Stchena/ANC-Thesis/Assets/prezentacja_prototyp_ukladu_aktywnej_redukcji_poziomu_halasu.pdf

# Prototyp układu

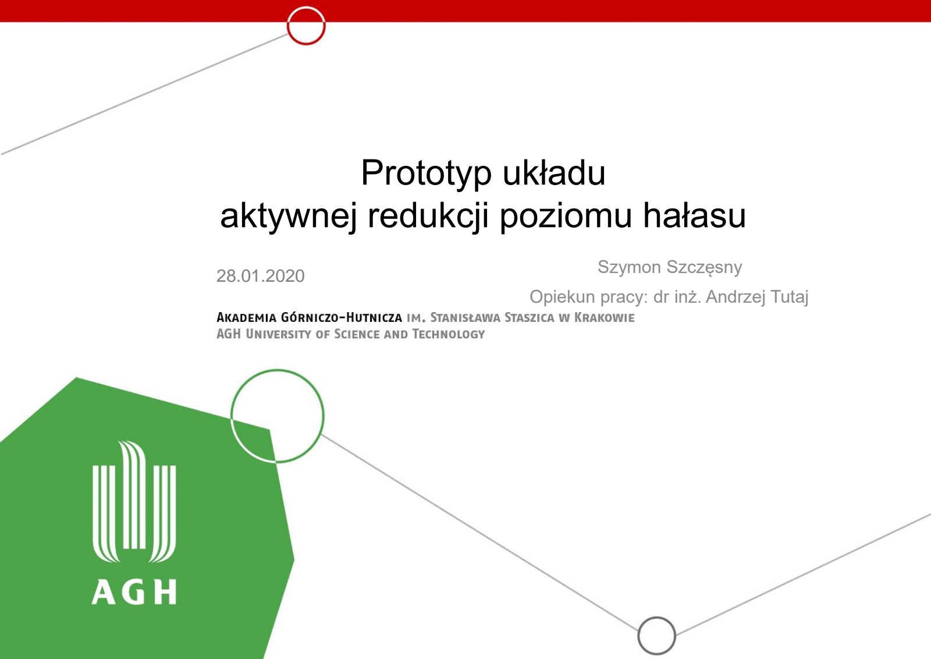
[picture p1: page 1]

# aktywnej redukcji poziomu hałasu

28.01.2020 | Szymon Szczęsny
| Opiekun pracy: dr inż. Andrzej Tutaj

# Charakterystyka Bodego nauszników – kiedy stosować tłumienie aktywne?

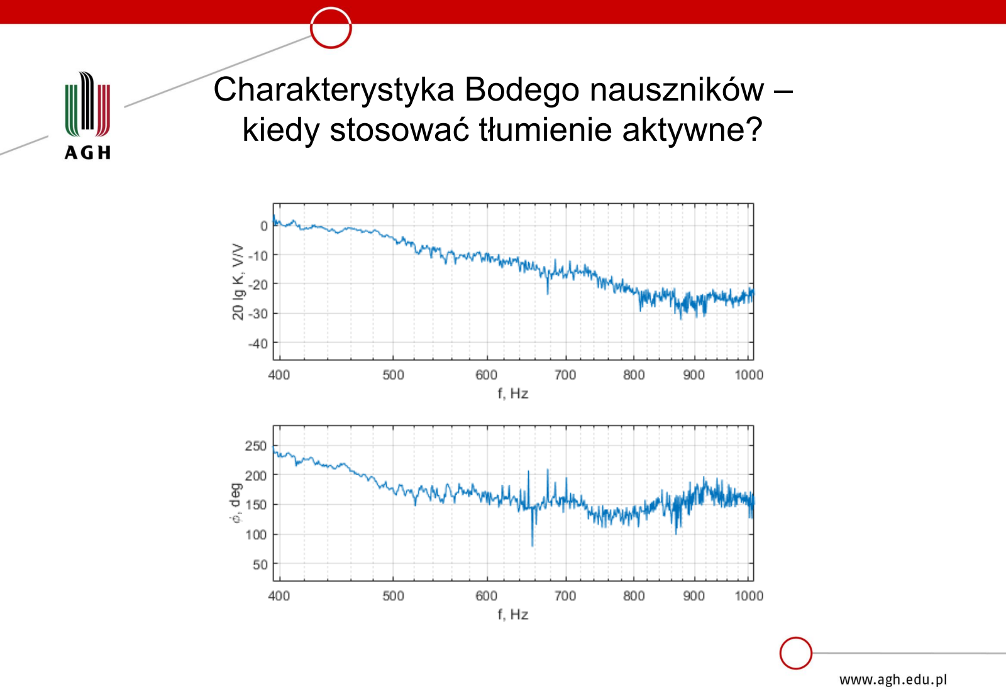
[picture p2: page 2]

Sinusoida 250 Hz

Wartość międzyszczytowa 6 Vpp

Rezonans głośnika –
wzmocnienie hałasu o 4,65 dB

Sinusoida 820 Hz

Wartość międzyszczytowa 8 Vpp

Granica pasma –
redukcja hałasu o 1 dB

# Adaptacyjny algorytm LMS

n – chwila czasu,
k – indeks współczynnika,
β – współczynnik zbieżności filtra, N – długość filtra.

FIR:

LMS:

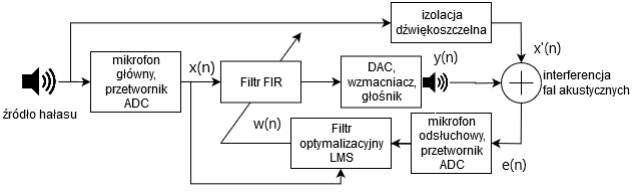
[picture p3: figure]

# Schemat działania urządzenia

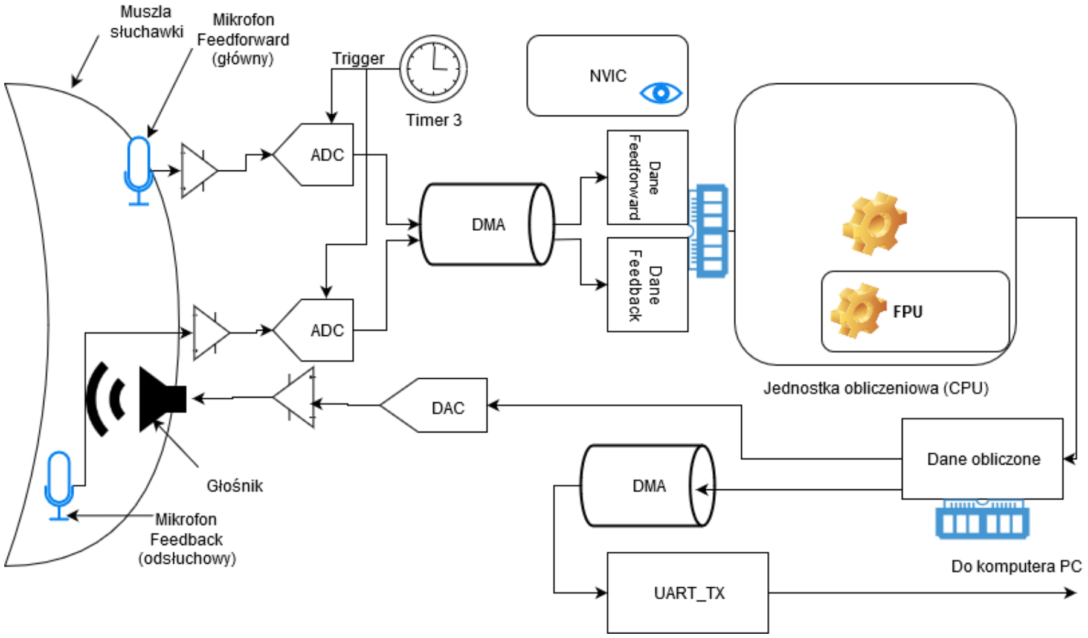
[picture p4: figure]

# Rozważane platformy sprzętowe:

# Układ analogowy

# Mikrokontroler

# Mikrokomputer

# Karta dźwiękowa

# Układ FPGA

# Główne cechy urządzenia

## » Pasywne tłumienie osiągnięte poprzez zastosowanie

nauszników tłumiących jako bazowej konstrukcji. » Układ typu feedforward-feedback,
a więc system predykcyjno-adaptacyjny.
» Użyty algorytm tłumienia to filtr FIR z LMS, rzędu 50. » Zbudowane na bazie mikrokontrolera STM32F446RE. » Transfer wag filtra LMS do PC poprzez UART.
» Tłumienie w zakresie od 400Hz do około 820Hz.

# Wyniki pomiarów

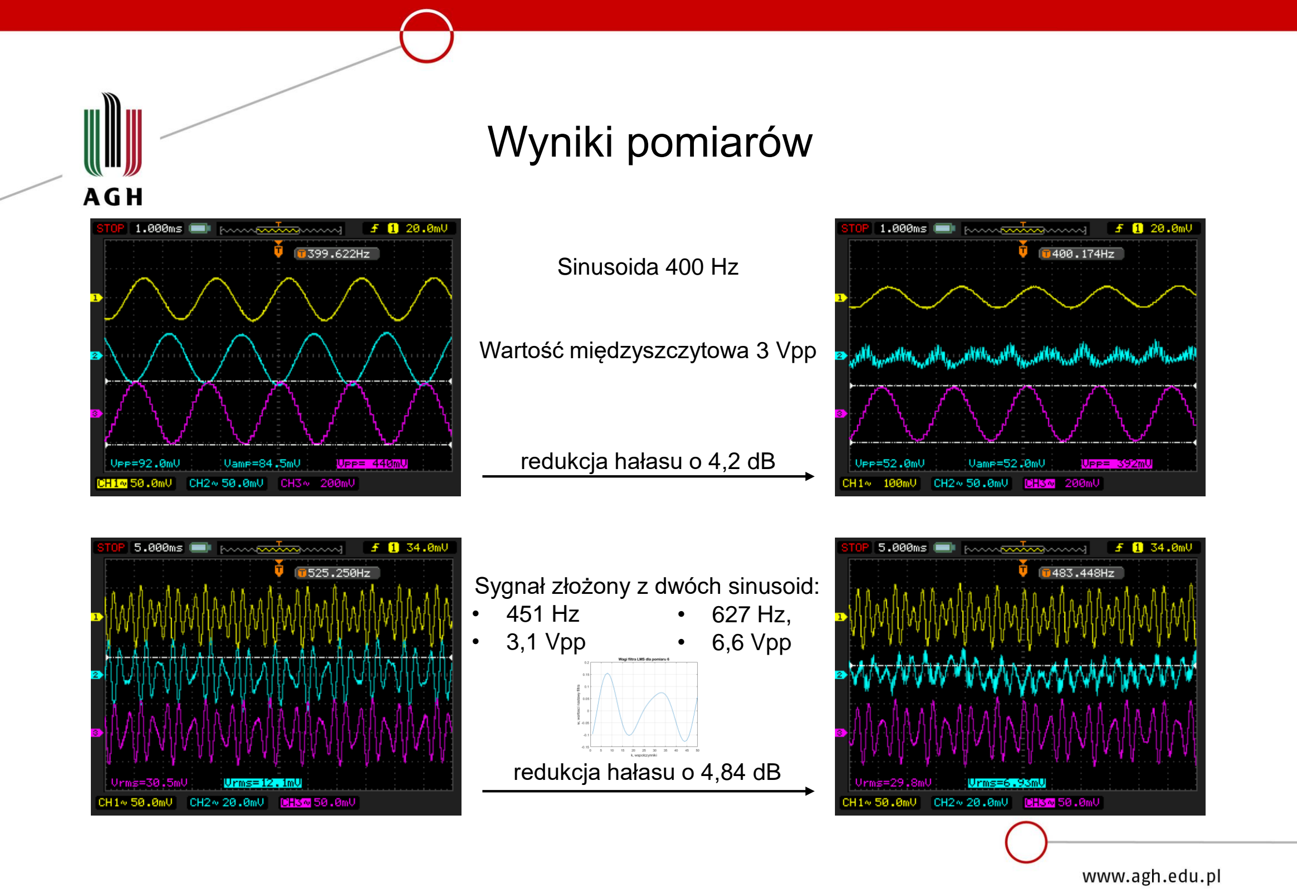
[picture p5: page 7]

Sinusoida 400 Hz

Wartość międzyszczytowa 3 Vpp

redukcja hałasu o 4,2 dB

Sygnał złożony z dwóch sinusoid:
- 451 Hz
- 3,1 Vpp
- 627 Hz,
- 6,6 Vpp

redukcja hałasu o 4,84 dB

# Wyniki pomiarów

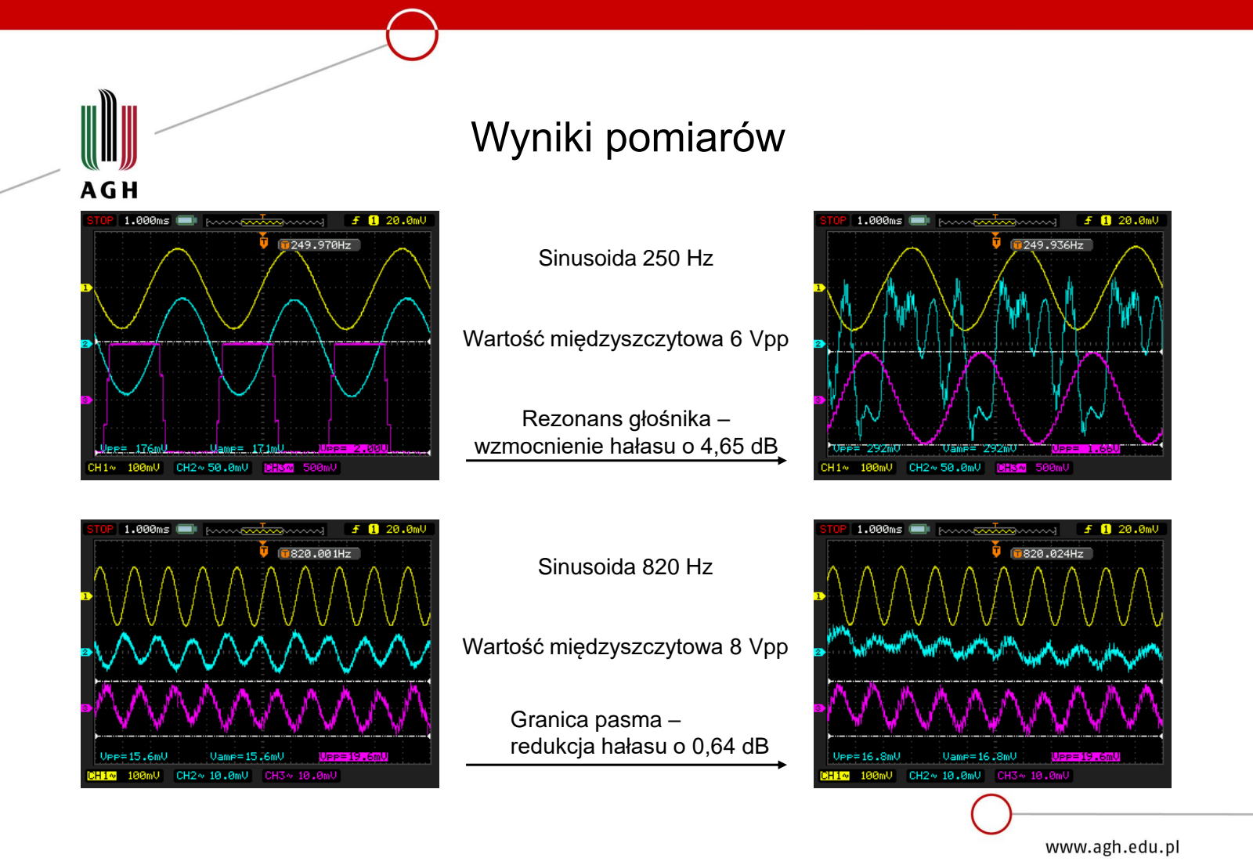
[picture p6: page 8]

Sinusoida 250 Hz

Wartość międzyszczytowa 6 Vpp

Rezonans głośnika –
wzmocnienie hałasu o 4,65 dB

Sinusoida 820 Hz

Wartość międzyszczytowa 8 Vpp

Granica pasma –
redukcja hałasu o 0,64 dB

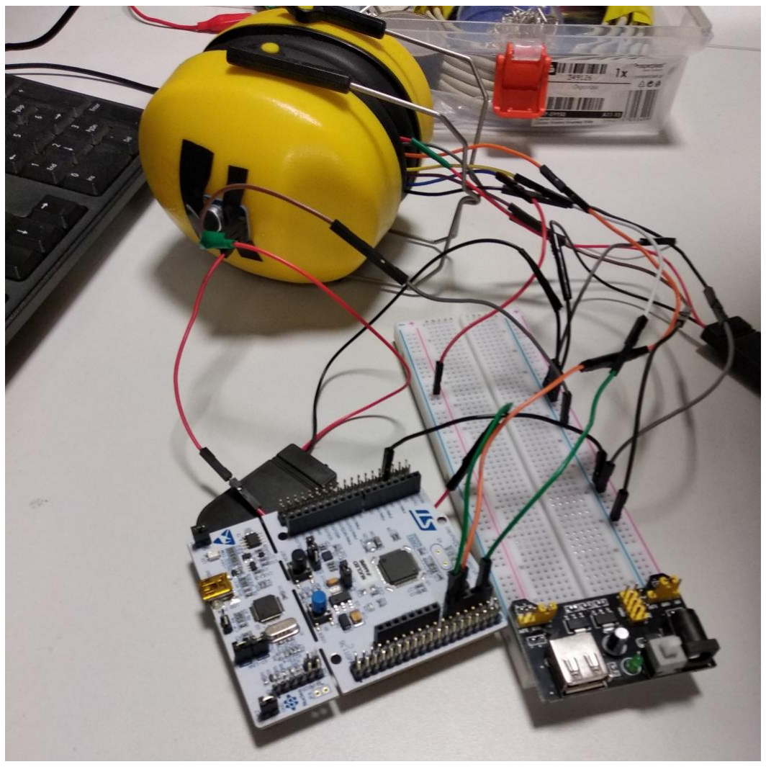
[picture p7: figure]

Poglądowy wygląd zewnętrzny urządzenia – użyte komponenty.

- Nauszniki tłumiące
- Płytka prototypowa
NUCLEO-F446RE
- Mikrofony – dwie sztuki
- Przedwzmacniacze – dwie sztuki
- Wzmacniacz audio
- Głośnik
- Płytka stykowa z modułem zasilającym
- Baterie 3V zasilające mikrofony – dwie sztuki
- Pasywny filtr dolnoprzepustowy I rzędu -antyaliasing

# Użyte komponenty:

## Łączny koszt urządzenia:

~220 zł

# Dziękuję za uwagę!

## Szymon Szczęsny
