Stchena/ANC-Thesis/Assets/Interference_of_two_waves.svg.png

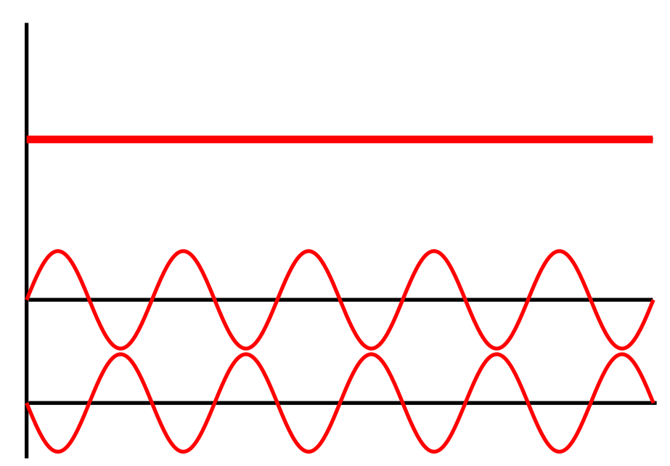
Assets/Interference_of_two_waves.svg.png
