Stchena/ANC-Thesis/Assets/modul_mb102.png

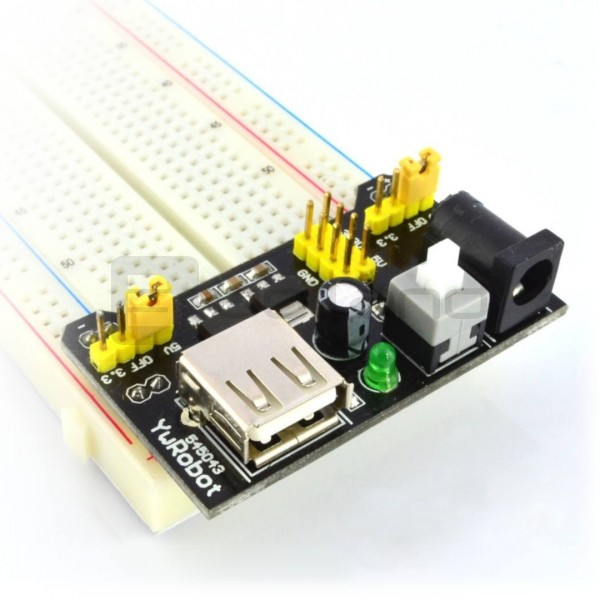
Assets/modul_mb102.png
