Stchena/ANC-Thesis/Assets/model_anc_rys.pdf

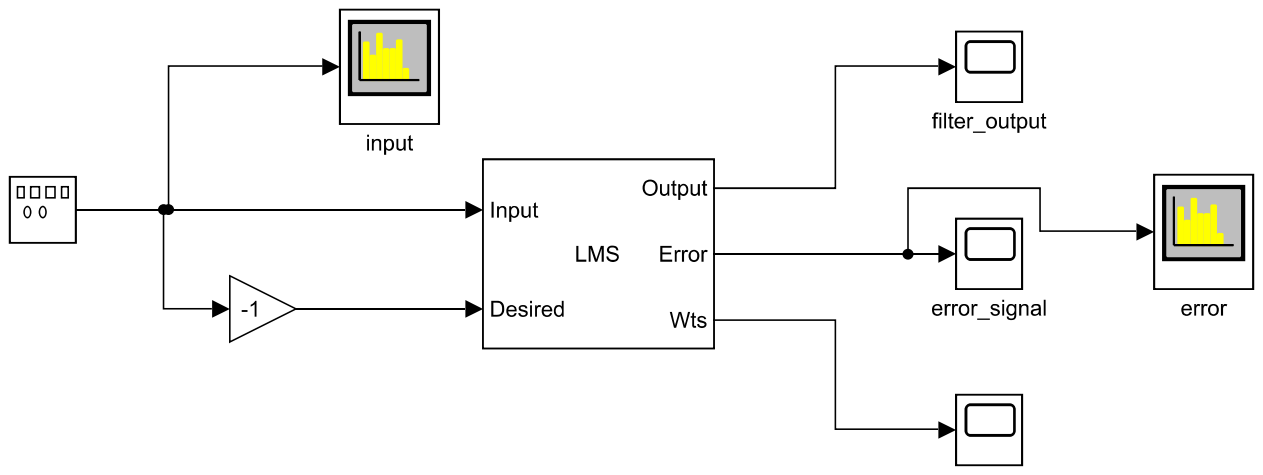
[picture p38: page 1]
