Stchena/ANC-Thesis/Configuration/Src/main.c

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

/* Includes ------------------------------------------------------------------*/
#include "main.h"

/* USER CODE BEGIN Includes */
#include <string.h>			// used for mem operations (memset, memmove)
#include <stdlib.h>			// needed for atoi - UART RX
/* USER CODE END Includes */

/* USER CODE BEGIN PD */
#define BETA 2E-4f			// LMS Convergence Rate
#define L 50				// Filter Order
#define V_REF 3.0f			// this should be changed in the future to dynamically calculate the DC offset of the signal
#define RESOLUTION 4096		// ADC and DAC resolution 12bit
#define DAC_LOW_TH 	850		// threshold for DAC buffer - at edge values it behaves weird ("rollover" of output voltage)
#define DAC_HIGH_TH 3250
/* USER CODE END PD */

ADC_HandleTypeDef hadc1;
ADC_HandleTypeDef hadc2;
DMA_HandleTypeDef hdma_adc1;

DAC_HandleTypeDef hdac;

TIM_HandleTypeDef htim3;

UART_HandleTypeDef huart2;
DMA_HandleTypeDef hdma_usart2_tx;

/* USER CODE BEGIN PV */
const float V_REF_HALF = V_REF/2.0f; 			// added as variable to speed up calculations
float samples[L];								// buffer of L input samples, where 0 is newest, L-1 is oldest
float weights[L];		 						// Filter coefficients (weights), where 0 is newest, L-1 is oldest
volatile uint32_t micInsideOutside = 0; 		// upper half word is hadc2, lower half word is hadc1 -- this is ADC in DMA Mode 2 behaviour
uint16_t output = 0;							// output of FIR filter to DAC
volatile uint8_t enable = 1;					// should ANC be enabled? default: 1
/* USER CODE END PV */

void SystemClock_Config(void);
static void MX_GPIO_Init(void);
static void MX_DMA_Init(void);
static void MX_ADC1_Init(void);
static void MX_ADC2_Init(void);
static void MX_DAC_Init(void);
static void MX_USART2_UART_Init(void);
static void MX_TIM3_Init(void);
/**
  * @brief  The application entry point.
  * @retval int
  */
int main(void)
{
  

  /* MCU Configuration--------------------------------------------------------*/

  /* Reset of all peripherals, Initializes the Flash interface and the Systick. */
  HAL_Init();

  /* Configure the system clock */
  SystemClock_Config();

  /* Initialize all configured peripherals */
  MX_GPIO_Init();
  MX_DMA_Init();
  MX_ADC1_Init();
  MX_ADC2_Init();
  MX_DAC_Init();
  MX_USART2_UART_Init();
  MX_TIM3_Init();
  /* USER CODE BEGIN 2 */
  HAL_ADC_Start(&hadc2);
  HAL_ADCEx_MultiModeStart_DMA(&hadc1, &micInsideOutside, 1);
  HAL_DAC_Start(&hdac, DAC_CHANNEL_1);
  HAL_TIM_Base_Start(&htim3); // start timer 3 to enable ADC triggering
  HAL_UART_Receive_IT(&huart2, (uint8_t*)&enable, 1);
  /* USER CODE END 2 */

  /* Infinite loop */
  /* USER CODE BEGIN WHILE */
  while (1)
  {
    /* USER CODE END WHILE */

    /* USER CODE BEGIN 3 */
  }
  /* USER CODE END 3 */
}

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
/* USER CODE BEGIN 4 */
/*
 *@brief UART Receive Callback -- Used for enable/disable algorithm from PC
 */
void HAL_UART_RxCpltCallback(UART_HandleTypeDef *huart)
{
	switch(atoi((uint8_t*)&enable))
	{
	case 0:
		HAL_GPIO_WritePin(GPIOA, GPIO_PIN_5, GPIO_PIN_RESET);
		// Send contents of weights buffer. Used while testing to create filter impulse response diagram.
		UartTransmitDMA();
		break;
	case 1:
		HAL_GPIO_WritePin(GPIOA, GPIO_PIN_5, GPIO_PIN_SET);
		break;
	default:
		break;
	}
	HAL_UART_Receive_IT(&huart2, (uint8_t*)&enable, 1); // enable await-receive again
}

void UartTransmitDMA(void)
{
	HAL_UART_Transmit_DMA(&huart2, (uint8_t*)weights, sizeof(float)*L);
}

/*
 *@brief FIR with LMS Algorithm filtering
 */
void HAL_ADC_ConvCpltCallback(ADC_HandleTypeDef* hadc)
{
	HAL_GPIO_WritePin(GPIOA, GPIO_PIN_5, GPIO_PIN_SET);
	if(!enable) return;
	short I;
	float fir_error = 0.0f;
	// shift the buffer
	memmove(samples+1, samples, (L-1)*sizeof(float));
	uint16_t feedforward_sample = (uint16_t)(micInsideOutside & 0x0000FFFF); // save new value from feedforward mic
	uint16_t feedback_sample = (uint16_t)((micInsideOutside & 0xFFFF0000) >> 16); // save new value from feedback mic

	samples[0] = feedforward_sample*V_REF/RESOLUTION - V_REF_HALF; // convert to float according to resolution
	fir_error = feedback_sample*V_REF/RESOLUTION - V_REF_HALF; // convert to float according to resolution
	// calculate filter output
	float weight_sum = 0.0f;
	float Yn = 0.0f;
	float* pweights = &weights[L-1];
	float* psamples = &samples[L-1];
	for(I=L-1; I>=0; --I)
	{
		*pweights = *pweights + BETA*fir_error*(*psamples);
		weight_sum += *pweights;
		Yn -= *(pweights--)*(*(psamples--)); // note that at last iteration pweights gets set to point at weights[-1] - this is handled in the next loop using preinc instead of postinc
	}
	for(I=L-1; I>=0; --I)
	{
		*(++pweights) -= 0.04f*weight_sum/((float)L); // DC drift reduction - calculate sum of weights, and if !=0 then drift the DC constant slowly towards 0 using part of this sum.
	}
	output = (uint16_t)((Yn+V_REF_HALF)*(RESOLUTION-1.0f)/V_REF);
	if(output<DAC_LOW_TH) output = DAC_LOW_TH;
	if(output>DAC_HIGH_TH) output = DAC_HIGH_TH; // saturate output, so that destabilised filter will generate square wave instead of frying speakers
	HAL_DAC_SetValue(&hdac, DAC_CHANNEL_1, DAC_ALIGN_12B_R, output);
	HAL_GPIO_WritePin(GPIOA, GPIO_PIN_5, GPIO_PIN_RESET); // connecting diode pin to oscilloscope allows for execution time examination
}
/* USER CODE END 4 */
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
