Stchena/ANC-Thesis/(commit log)

2019-10-22 Adding document class and STM config to repo
    Summary:
    - Added document class
    - Added configuration file from STM32CubeMX
    - Tidy up directories
2019-10-23 Improvements to chapters and adding bibliography
    - Moving sections
    - Renaming chapters and sections
    - Added a few positions to the bibliography with sample citations
    - Tidy chapter layout
    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
2019-12-08 Updated configuration file and calculated total sampling times
    1. Dual ADC synchro mode
    2. Set sampling times.
    3. Reviewed the configuration.
    4. Code generation based on .ioc file.
    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
2019-12-16 Part of Chapter 5
    - Intro to chap5
    - Part about hardware
    - Part about configuration of ADC
    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
2019-12-29 Finished conversion from converter_word to float
    - Now the calculations are being performed on proper floating point
    values reflecting the real voltage in range -1.5:1.5
    - Final value is then converted back into converter_word
    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
2020-01-06 Added check for enabled parameter - will elaborate later
    - modified some variables
    - added check for enable algorithm - later will change it with button or
    uart command from pc
    - need to program uart data Tx
    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
2020-01-08 Added some assets and modified minor stuff in chapters
    - Photos of some of the components used
    - Modified system schematic
    - Minor changes in chapters
    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
2020-01-08 Changes in algorithm and configuration
    - Added casting to float in some variables in algorithm
    - Added Transmit uart fcn call in ISR from button push
    - Modified code so that error samples are collected for 15 seconds
    - Then the buffer is sent through UART-STLink-PC
    - Need to make sure the interrupt callbacks are correctly called
    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
    [Configuration.ioc, main.c]
2020-01-13 Working program
    - Changed timer to 3 (from 1)
    - Output compare no output
    - trigger event selection: update event
    - mode Frozen
    - auto reload preload enable
    - need to debug buffer_count - gets overwritten by data from ADC
    - BY THE POWER OF VALGRIND - BEGONE, MEM_CORRUPT!
    - Fs equal to 2kHz now
    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
2020-01-14 Fixing minor mistakes, formatting text and modifying the presentation.
    - Fixes
    - New assets
    - Changed formatting in a few spots
    - Modified presentation
    - Removed the copyright clausule from titlepage, it is an attachment now
    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
2020-01-22 Final version of configuration and program
    - Attenuation of non-disturbed sinusoides from 200 to 1000Hz
    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
2020-01-23 Changes to align text with what was achieved
    - Changed type of test
    - Changed some components configuration
    - Changed schematics
    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
2020-02-03 Optimization of main algorithm loops + presentation
    - Changed array access to pointer based instead of iterator based
    - Changed sample buffer shifting to memmove operation instead of slow
    for-loop
    - Changed a formula in the latex class
    - Added a presentation for thesis exam
    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
